ristich/TC0xC/Art/review_back.png

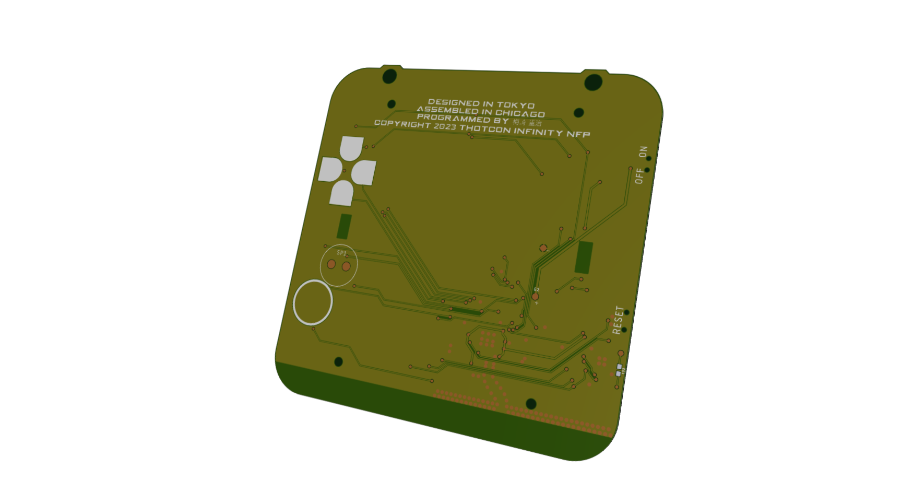
Art/review_back.png
