ristich/TC0xC/Art/review_front.png

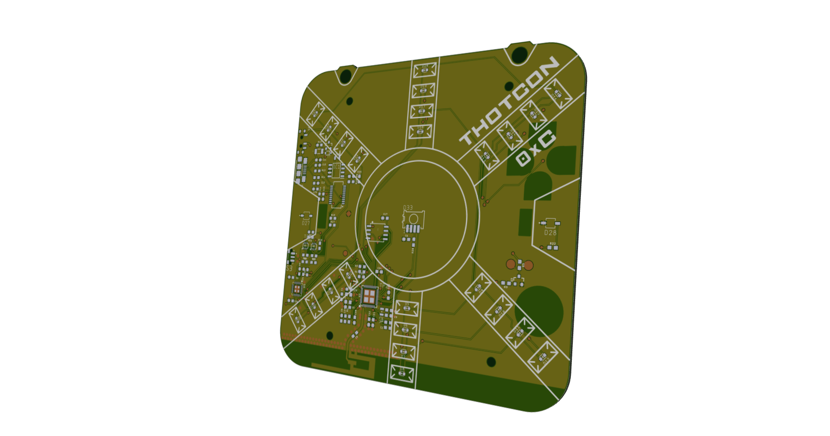
Art/review_front.png
