ristich/TC0xC/Hardware/Release/BOM_FINAL.xlsx

THOTCON 0xC Final Release
Item # | Quantity per board | Manufacturer Part # | Do Not Install | Reference designators | Vendor (optional) | Vendor Part Number (optional) | Part description/ specs (optional, but recommended) | Manfacturer (optional)
1 | 2 | 06035A271JAT2A |  | C1, C2 | Digi-Key | 478-1180-1-ND | CAP CER 270PF 50V C0G/NP0 0603 | KYOCERA AVX
2 | 2 | C0603C100J5GACTU |  | C3, C4 | Digi-Key | 399-C0603C100J5GAC7867CT-ND | CAP CER 10PF 50V C0G/NP0 0603 | KEMET
3 | 1 | GCM188R71H103KA37D |  | C5 | Digi-Key | 490-4778-1-ND | CAP CER 10000PF 50V X7R 0603 | Murata Electronics
4 | 10 | C0603C104Z3VACTU |  | C11, C14, C17, C20, C21, C23, C25, C75, C6, C35 | Digi-Key | 399-C0603C104Z3VAC7867CT-ND | CAP CER 0.1UF 25V Y5V 0603 | KEMET
5 | 1 | C0603C569J5GACTU |  | C8 | Digi-Key | 399-C0603C569J5GAC7867CT-ND | CAP CER 5.6PF 50V C0G/NP0 0603 | KEMET
6 | 2 | 06035A150JAT2A |  | C9, C26 | Digi-Key | 478-1165-1-ND | CAP CER 15PF 50V C0G/NP0 0603 | KYOCERA AVX
7 | 2 | 06035A470JAT2A |  | C12, C13 | Digi-Key | 478-1171-1-ND | CAP CER 47PF 50V C0G/NP0 0603 | KYOCERA AVX
8 | 1 | C0603C475K9PACTU |  | C15 | Digi-Key | 399-C0603C475K9PAC7867CT-ND | CAP CER 4.7UF 6.3V X5R 0603 | KEMET
9 | 1 | CL10C101JB8NNNC |  | C18 | Digi-Key | 1276-1008-1-ND | CAP CER 100PF 50V C0G/NP0 0603 | Samsung Electro-Mechanics
10 | 1 | JMK107ABJ106MA-T |  | C22 | Digi-Key | 587-5869-1-ND | CAP CER 10UF 6.3V X5R 0603 | Taiyo Yuden
11 | 2 | CL10A105KO8NNNC |  | C24, C34 | Digi-Key | 1276-1034-1-ND | CAP CER 1UF 16V X5R 0603 | Samsung Electro-Mechanics
12 | 1 | GRM1887U1H302JA01D |  | C27 | Digi-Key | 490-6396-1-ND | CAP CER 3000PF 50V U2J 0603 | Murata Electronics
13 | 1 | CC0805ZRY5V8BB105 |  | C29 | Digi-Key | 311-1358-1-ND | CAP CER 1UF 25V Y5V 0805 | YAGEO
14 | 1 | LMK107B7225KA-T |  | C30 | Digi-Key | 587-2983-1-ND | CAP CER 2.2UF 10V X7R 0603 | Taiyo Yuden
15 | 1 | C0603C224K3RACTU |  | C32 | Digi-Key | 399-C0603C224K3RAC7867CT-ND | CAP CER 0.22UF 25V X7R 0603 | KEMET
16 | 2 | VSMB2020X01 |  | D27,D28 | Digi-Key | VSMB2020X01CT-ND | EMITTER IR 940NM 100MA SMD | Vishay Semiconductor Opto Division
17 | 25 | LTST-C190KRKT |  | D1, D2, D3, D4, D5, D6, D7, D8, D9, D10, D11, D12, D13, D14, D15, D16, D17, D18, D19, D20, D21, D22, D23, D24, D26 | Digi-Key | 160-1436-1-ND | LED RED CLEAR CHIP SMD | Lite-On Inc.
18 | 1 | PTS120615V050 |  | F1 | Digi-Key | 283-3140-1-ND | PTC RESET FUSE 15V 500MA 1206 | Eaton - Electronics Division
19 | 1 | 10118192-0002LF |  | J1 | Digi-Key | 609-5379-1-ND | CONN RCPT USB2.0 MICRO B SMD R/A | Amphenol ICC (FCI)
21 | 1 | SI2307BDS-T1-E3 |  | Q1 | Digi-Key | SI2307BDS-T1-E3CT-ND | MOSFET P-CH 30V 2.5A SOT23-3 | Vishay Siliconix
22 | 2 | MBT3904DW1T1G |  | Q2,Q4 | Digi-Key | MBT3904DW1T1GOSCT-ND | TRANS 2NPN 40V 0.2A SC88/SC70-6 | onsemi
23 | 1 | PBSS4350T,215 |  | Q3 | Digi-Key | 1727-5113-1-ND | TRANS NPN 50V 2A TO236AB | Nexperia USA Inc.
24 | 12 | RMCF0603JT10K0 |  | R1, R3, R4, R7, R8, R10, R12, R17, R18, R19 | Digi-Key | RMCF0603JT10K0CT-ND | RES 10K OHM 5% 1/10W 0603 | Stackpole Electronics Inc
25 | 2 | ERJ-3EKF2002V |  | R2,R6 | Digi-Key | RMCF0603FT20K0TR-ND | RES SMD 20K OHM 1% 1/10W 0603 | Panasonic Electronic Components
26 | 2 | ERA-3AHD270V |  | R13, R14 | Digi-Key | P123789CT-ND | RES SMD 27 OHM 0.5% 1/10W 0603 | Panasonic Electronic Components
27 | 5 | RNCP0603FTD1K00 |  | R5,R9,R11,R15,R16 | Digi-Key | RNCP0603FTD1K00CT-ND | RES 1K OHM 1% 1/8W 0603 | Stackpole Electronics Inc
28 | 1 | TL3340AF160QG |  | S3 | Digi-Key | EG4627CT-ND | SWITCH TACTILE SPST-NO 0.05A 12V | E-Switch
29 | 1 | ESP32-D0WDQ6 |  | U2 | Digi-Key | 1904-1004-1-ND | IC RF TXRX+MCU BLUETOOTH 48VFQFN | Espressif Systems
30 | 1 | AP2112K-3.3TRG1 |  | IC1 | Digi-Key | AP2112M-3.3TRG1DICT-ND | IC REG LINEAR 3.3V 600MA 8SOIC | Diodes Incorporated
31 | 1 | FT231XS-R |  | U4 | Newark | 83T7089 | FT231XS-R Interface RS232, RS422, RS485, SIE, UART 3MBd, 5 V, 20-Pin, SSOP | FTDI
32 | 1 | W25Q32JVSSIQ |  | U5 | Digi-Key | WICC-1062-ND | IC FLASH 32MBIT SPI/QUAD 8SOIC - custom flash | Winbond Electronics
33 | 1 | TSOP36138TT |  | D33 | Mouser | 782-TSOP36138TT | Infrared Receivers 2.7-5.5V 38kHz 45Deg | Vishay Semiconductors
34 | 1 | IS31FL3731-QFLS2-TR |  | U1 | Digi-Key | 2521-IS31FL3731-QFLS2-TRCT-ND | IC LED DRV LIN ANALOG 34MA 28QFN | Lumissil Microsystems
36 | 1 | TSX-3225 26.0000MF09Z-AC3 |  | Y1 | Digi-Key | SER3627CT-ND | CRYSTAL 26.0000MHZ 9PF SMD | EPSON
37 | 1 | FC-135 32.7680KA-A5 |  | Y2 | Digi-Key | SER4080CT-ND | CRYSTAL 32.7680KHZ 12.5PF SMD | EPSON
38 | 1 | CUS-12TB |  | S2 | Digi-Key | 563-1102-1-ND | SWITCH SLIDE SPDT 300MA 4V | Nidec Copal Electronics
39 | 1 | 1N5711WS-7-F |  | D25 | Digi-Key | 1N5711WS-FDICT-ND | DIODE SCHOTTKY 70V 150MW SOD323 | Diodes Incorporated
40 | 1 | RNCP0603FTD100R |  | R20 | Digi-Key | RNCP0603FTD100RCT-ND | RES 100 OHM 1% 1/8W 0603 | Stackpole Electronics Inc
41 | 1 | 2479 |  | G2 | Digi-Key | 36-2479-ND | Battery Holder AAA 3 Cell PN PIN | Keystone
42 | 1 | PS1240P02BT |  | SP1 | Digi-Key | 445-2525-1-ND | AUDIO PIEZO TRANSDUCER 30V TH | TDK Corporation
43 | 2 | 755-SDR03EZPJ241 |  | R21,R22 | Mouser | 755-SDR03EZPJ241 | 240 Ohm 0603 R 5% tol | Rohm Semiconductor
44 | 2 | RT0603FRE13100KL |  | R24,R25 | Mouser | 603-RT0603FRE13100KL | 100K Ohm 0603 R 5% tol | Yageo
45 | 2 | CRG0603F22R |  | R23,R26 | Mouser | 279-CRG0603F22R | 22 Ohm 0604 R 5% tol | TE Connectivity
46 | 2 | RUC002N05 HZG |  | Q5,Q6 | Digi-Key | RUC002N05HZGT116CT-ND | Nch 50V 200mA Small Signal MOSFET | Rohm Semiconductor
END OF BOM
