ristich/TC0xC/Hardware/Prototype/thot_C_proto_bom.xlsx

Item # | Qty | Ref. Des | Manufacturer | Mfg. Part # | Dist. Part # | Description | Value | Device | Package | PROD_ID
1 | 2 | C1, C2 | AVX | 06035A271JAT2A | 478-1180-1-ND | CAP-13339 | 270pF | 270PF-50V-5%(0603) | 603 | CAP-13339
2 | 2 | C3, C4 | Kemet | C0603C100J5GACTU | 399-1049-1-ND | 10pF ceramic capacitors | 10pF | 10PF-0603-50V-5% | 603 | CAP-11812
3 | 1 | C5 | Murata | GCM188R71H103KA37D | 490-4778-1-ND | 0.01uF/10nF/10,000pF ceramic capacitors | 10nF | 10NF-0603-50V-10% | 603 | CAP-00867
4 | 11 | C7, C11, C14, C16, C17, C20, C21, C23, C25, C33, C35 | Kemet | C0603C104Z3VACTU | 399-1100-1-ND | 0.1µF ceramic capacitors | 0.1uF | 0.1UF-0603-25V-(+80/-20%) | 603 | CAP-00810
5 | 1 | C8 | Kemet | C0603C569J5GACTU | 399-9111-1-ND | CAP-12456 | 5.6pF | 5.6PF-50V-5%(0603) | 603 | CAP-12456
6 | 2 | C9, C26 | AVX | 06035A150JAT2A | 478-1165-1-ND | 15pF ceramic capacitors | 15pF | 15PF-0603-50V-5% | 603 | CAP-07881
7 | 2 | C12, C13 | AVX | 06035A470JAT2A | 478-1171-1-ND | 47pF ceramic capacitors | 47pF | 47PF-0603-50V-5% | 603 | CAP-08913
8 | 1 | C15 | Kemet | C0603C475K9PACTU | 399-3482-1-ND | CAP-08280 | 4.7uF | 4.7UF-6.3V-10%(0603)0603 | 0603-CAP | CAP-08280
9 | 1 | C18 | Samsung | CL10C101JB8NNNC | 490-1427-1-ND | 100pF/0.1nF ceramic capacitors | 100pF | 100PF-0603-50V-5% | 603 | CAP-07883
10 | 2 | C22, C31 | Taiyo Yuden | JMK107ABJ106MA-T | 587-5869-1-ND | 10.0 µF ceramic capacitors | 10uF | 10UF-0603-6.3V-20% | 603 | CAP-11015
11 | 2 | C24, C34 | Samsung | CL10A105KO8NNNC | 1276-1034-1-ND | 1µF ceramic capacitors | 1.0uF | 1.0UF-0603-16V-10% | 603 | CAP-00868
12 | 1 | C27 | Murata | GRM1887U1H302JA01D | 490-6396-1-ND | 3.0nF (3nF, 3000pF) ceramic capacitors | 3.0nF | 3.0NF-0603-50V-5% | 603 | CAP-13515
13 | 1 | C29 | Yageo | CC0805ZRY5V8BB105 | 311-1358-1-ND | 1µF ceramic capacitors | 1.0uF | 1.0UF-0805-25V-(+80/-20%) | 805 | CAP-11625
14 | 1 | C30 | Taiyo Yuden | LMK107B7225KA-T | 587-2983-1-ND | 2.2 µF ceramic capacitors | 2.2uF | 2.2UF-0603-10V-20% | 603 | CAP-07888
15 | 1 | C32 | Kemet | C0603C224K3RACTU | 399-7884-1-ND | 0.22µF Ceramic Capacitor | 0.22uF | 0.22UF-0603-25V-10% | 603
16 | 2 | D1,D4 | Vishay | VSMB2020X01 | 782-VSMB2020X01 | Infrared Emitters - High Power 940nm, SMD 40mW/sr, +/-12deg. | 950nM | INFRARED-EMITTING DIODE | 2-SMD, Gull Wing
17 | 1 | D2 | ON Semiconductor | MMDL770T1G | MMDL770T1GOSCT-ND | Schottky diodes in SFE's production catalog | BAT20J | DIODE-SCHOTTKY-BAT20J | SOD-323 | DIO-11623
18 | 1 | D3 | Lite-ON | LTST-C191KFKT | 160-1445-1-ND | Orange SMD LED | ORANGE | LED-RED0603 | LED-0603 | DIO-00819
19 | 24 | D1-24 | Lite-ON | LTST-C190KRKT | 160-1436-1-ND | LED RED CLEAR 2PLCC SMD | RED | LED-RED0603 | LED-0604
20 | 1 | F1 | Cooper Bussmann | PTS120615V050 | 283-3140-1-ND | Resettable Fuse PTC | 500mA | PTCSMD | PTC-1206 | RES-11150
21 | 1 | J1 | Amphenol ICC (FCI) | 10118192-000 2 LF | 609-5379-1-ND | USB Micro-B connectors |  | USB_MICROB_PLUGCONN-11752 | USB-B-MICRO-SMD_V03 | CONN-11752
22 | 1 | LS1 | TDK Corporation | PS1240P02BT | 445-2525-1-ND | AUDIO PIEZO TRANSDUCER 30V TH |  |  | Through Hole
23 | 1 | Q1 | Vishay | SI2307BDS-T1-E3 | SI2307BDS-T1-E3CT-ND | Generic PMOSFET | 2.5A/30V | MOSFET-PCHANNELDMG2307L | SOT23-3 | TRANS-11308
24 | 1 | Q2 | ON Semiconductor | MBT3904DW1T1G | MBT3904DW1T1GOSCT-ND | MBT3904DW1 Dual NPN Transistors | MBT3904DW1T1 | MBT3904DW1T1 | SC70-6 | TRANS-13337
25 | 1 | Q3 | Nexperia | PBSS4350T,215 | 1727-5113-1-ND | TRANS NPN 50V 2A SOT23 |  |  | SOT-23-3
26 | 10 | R1, R3, R4, R8, R9, R12, R17, R18, R19, R20 | Stackpole | RMCF0603JT10K0 | RMCF0603JT10K0CT-ND | 10k resistor | 10k | 10KOHM-0603-1/10W-1% | 603 | RES-00824
27 | 1 | R2 | Panasonic | ERJ-3EKF2002V | P20.0KHCT-ND | 20k resistor | 20k | 20KOHM-0603-1/10W-1% | 603 | RES-09383
28 | 2 | R13, R14 | Panasonic | ERA-3AHD270V | P123789CT-ND | RES-09334 | 27 | 27OHM1/10W1%(0603)0603-RES | 603 | RES-09334
29 | 1 | R15 | Panasonic | ERA-3AED102V | P123733CT-ND | RES-07856 | 1K | 1KOHM-1/10W-1%(0603) | 603 | RES-07856
30 | 1 | S1 | C&K Components | KMR223GLFG | 401-1428-1-ND | Various NO switches- pushbuttons, reed, etc | RESET | SWITCH-MOMENTARY-2SMD-4.6X2.8MM | TACTILE_SWITCH_SMD_4.6X2.8MM | SWCH-13065
31 | 1 | U2 | Espressif | ESP32-D0WDQ6 | 1904-1004-1-ND | ESP32 IC | ESP3212 | ESP3212 | QFN48-0.4MM | IC-13338
32 | 1 | U3 | Diodes Incorporated | AP2112K-3.3TRG1 | AP2112K-3.3TRG1DICT-ND | Voltage Regulator LDO | AP2112K-3.3V | V_REG_LDOSMD | SOT23-5 | VREG-12457
33 | 1 | U4 | FTDI | FT231XS-R | 83T7089 | FTDI FT231X Full Speed USB to Full-handshake UART | FT231XS | FT231XS | SSOP20_L | IC-11524
34 | 1 | U5 | Winbond | W25Q32JVSSIQ | W25Q32JVSSIQ-ND | Winbond W25Q32FV 32Mbit (4MB) Flash | W25Q32FVSS | W25Q32FVSS | SOIC-8 | IC-13229
35 | 1 | D33 | Vishay | TSOP36138TT | 782-TSOP36138TT | Infrared Receivers 2.7-5.5V 38kHz 45Deg | 38 kHz | TSOP36138 | LGA-16
36 | 1 | U7 | ISSI | IS31FL3731-QFLS2-TR | 870-31FL3731-QFLS2TR | LED Driver IC 16 Output Linear I²C Dimming 24-QFN (4x4) |  |  | QFN-24
37 | 1 | U$15 | Keystone | 2479 | 36-2479-ND | Battery Holder AAA 3 Cell PN PIN | n/a | 2479 | THRU-PCB
38 | 1 | Y1 | Epson | TSX-3225 26.0000MF09Z-AC3 | SER3627CT-ND | 26MHz Crystal | 26MHz | CRYSTAL-GROUNDED3.2X2.5 | CRYSTAL-SMD-3.2X2.5 | XTAL-12454
39 | 1 | Y2 | Epson | FC-135 32.7680KA-A5 | SER4103CT-ND | 32.768kHz Crystal | 32.768kHz | CRYSTAL-32.768KHZSMD-3.2X1.5 | CRYSTAL-SMD-3.2X1.5MM | XTAL-13062
40 | 2 |  |  | RC0603FR-078R2L | 13-RC0603FR-078R2LTR-ND | 8.2 Resitor | 8.2
41 | 1 | S
