ristich/TC0xC/Hardware/Housing/TC0xC_cover_inner.step

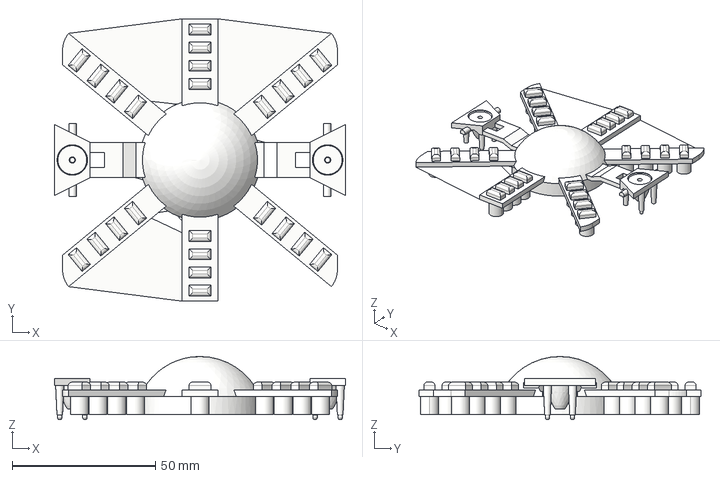
[picture p3: CAD file, 2023-03-19]
Hardware/Housing/TC0xC_cover_inner.step
101.6 x 98.6 x 22.0 mm
