ristich/TC0xC/Hardware/Housing/TC0xC_cover_outer.step

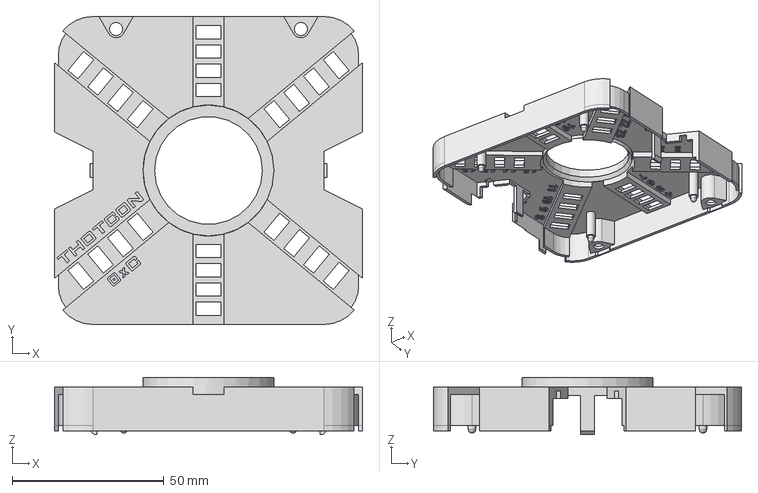
[picture p4: CAD file, 2023-03-19]
Hardware/Housing/TC0xC_cover_outer.step
101.6 x 101.6 x 18.9 mm
