ristich/TC0xC/(list of files, cad)

Other CAD files:
Hardware/Housing/TC0xC_cover_inner.stl
Hardware/Housing/TC0xC_cover_outer.stl
