ristich/TC0xC/Hardware/Release/tc0xC_prod.brd

## EAGLE design Hardware/Release/tc0xC_prod.brd (2023-04-10)

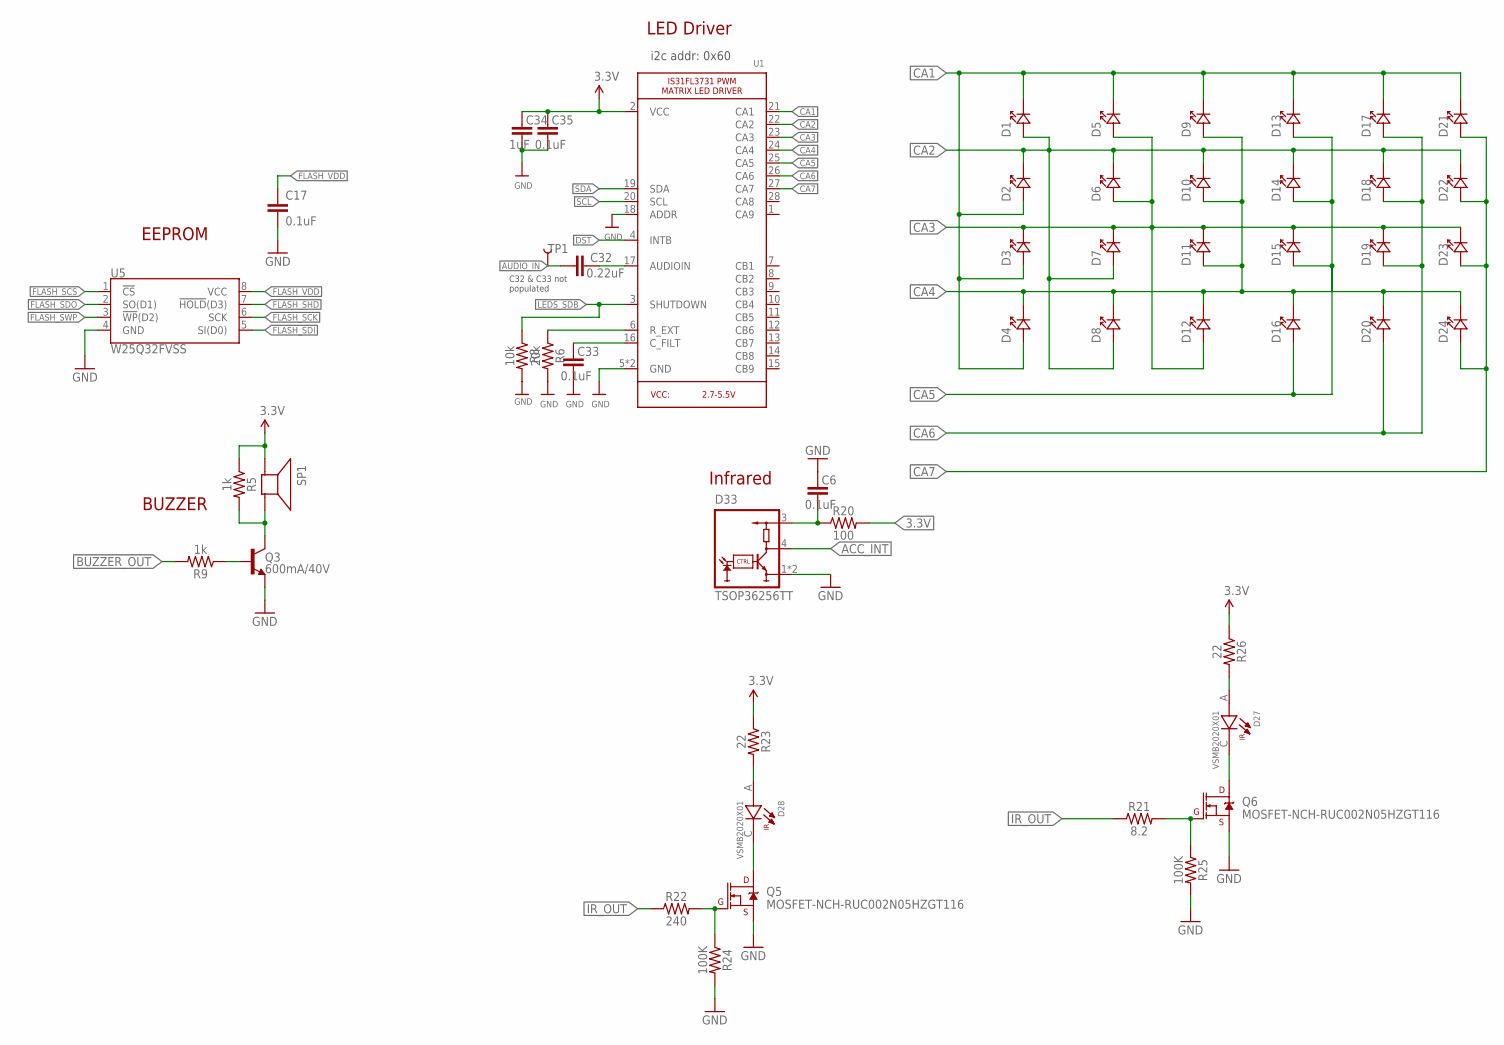
[picture p5: schematic tc0xC_prod.sch, sheet 1]

Parts:
C6, C17, C33, C35: 0.1uF; 0603
C32: 0.22uF; 0603
C34: 1uF; 0603
D1, D2, D3, D4, D5, D6, D7, D8, D9, D10, D11, D12, D13, D14, D15, D16, D17, D18, D19, D20, D21, D22, D23, D24: LED-603; SMD-603
D27, D28: VSMB2020X01; DIO_VSMB2020X01
D33: TSOP36256TT; TSOP36256
Q3: 600mA/40V; SOT23-3
Q5, Q6: MOSFET-NCH-RUC002N05HZGT116; SOT-23-3
R5, R9: 1k; 0603
R6: 20k; 0603
R8: 10k; 0603
R20: 100; 0603
R21: 8.2; 0603
R22: 240; 0603
R23, R26: 22; 0603
R24, R25: 100K; 0603
SP1: SPEAKER/PS12; PS12
TP1: TEST-POINT3X5; PAD.03X.05
U1: IS31FL3731QFN; QFN-28_4MM_0.4MM
U5: W25Q32FVSS; SOIC-8

Connections:
3.3V: C34.1, C35.1, R5.1, R20.2, R23.1, R26.1, SP1.P$1 (+), U1.2 (VCC); also elsewhere on the board
ACC_INT: D33.4 (OUT); also elsewhere on the board
AUDIO_IN: C32.1, TP1.P$1
BUZZER_OUT: R9.2; also elsewhere on the board
CA1: D1.P$2 (CATHODE-), D2.P$1 (ANODE+), D3.P$1 (ANODE+), D4.P$1 (ANODE+), D5.P$2 (CATHODE-), D9.P$2 (CATHODE-), D13.P$2 (CATHODE-), D17.P$2 (CATHODE-), D21.P$2 (CATHODE-), U1.21 (CA1)
CA2: D1.P$1 (ANODE+), D2.P$2 (CATHODE-), D6.P$2 (CATHODE-), D7.P$1 (ANODE+), D8.P$1 (ANODE+), D10.P$2 (CATHODE-), D14.P$2 (CATHODE-), D18.P$2 (CATHODE-), D22.P$2 (CATHODE-), U1.22 (CA2)
CA3: D3.P$2 (CATHODE-), D5.P$1 (ANODE+), D6.P$1 (ANODE+), D7.P$2 (CATHODE-), D11.P$2 (CATHODE-), D12.P$1 (ANODE+), D15.P$2 (CATHODE-), D19.P$2 (CATHODE-), D23.P$2 (CATHODE-), U1.23 (CA3)
CA4: D4.P$2 (CATHODE-), D8.P$2 (CATHODE-), D9.P$1 (ANODE+), D10.P$1 (ANODE+), D11.P$1 (ANODE+), D12.P$2 (CATHODE-), D16.P$2 (CATHODE-), D20.P$2 (CATHODE-), D24.P$2 (CATHODE-), U1.24 (CA4)
CA5: D13.P$1 (ANODE+), D14.P$1 (ANODE+), D15.P$1 (ANODE+), D16.P$1 (ANODE+), U1.25 (CA5)
CA6: D17.P$1 (ANODE+), D18.P$1 (ANODE+), D19.P$1 (ANODE+), D20.P$1 (ANODE+), U1.26 (CA6)
CA7: D21.P$1 (ANODE+), D22.P$1 (ANODE+), D23.P$1 (ANODE+), D24.P$1 (ANODE+), U1.27 (CA7)
DST: U1.4 (INTB); also elsewhere on the board
FLASH_SCK: U5.6 (SCK); also elsewhere on the board
FLASH_SCS: U5.1 (!CS!); also elsewhere on the board
FLASH_SDI: U5.5 (SI(D0)); also elsewhere on the board
FLASH_SDO: U5.2 (SO(D1)); also elsewhere on the board
FLASH_SHD: U5.7 (!HOLD!(D3)); also elsewhere on the board
FLASH_SWP: U5.3 (!WP!(D2)); also elsewhere on the board
FLASH_VDD: C17.1, U5.8 (VCC); also elsewhere on the board
GND: C6.1, C17.2, C33.2, C34.2, C35.2, D33.1 (GND), D33.2 (GND), Q3.2 (E), Q5.2 (S), Q6.2 (S), R6.2, R8.2, R24.2, R25.2, U1.5 (GND), U1.18 (ADDR), U1.THERMAL (GND), U5.4 (GND); also elsewhere on the board
IR_OUT: R21.1, R22.1; also elsewhere on the board
LEDS_SDB: R8.1, U1.3 (SHUTDOWN); also elsewhere on the board
unnamed: C33.1, U1.16 (C_FILT)
unnamed: R6.1, U1.6 (R_EXT)
unnamed: Q3.3 (C), R5.2, SP1.P$2 (-)
unnamed: Q6.1 (G), R21.2, R25.1
unnamed: Q5.1 (G), R22.2, R24.1
unnamed: C32.2, U1.17 (AUDIOIN)
unnamed: C6.2, D33.3 (VS), R20.1
unnamed: D28.C, Q5.3 (D)
unnamed: D28.A, R23.2
unnamed: D27.C, Q6.3 (D)
unnamed: D27.A, R26.2
unnamed: Q3.1 (B), R9.1
SCL: U1.20 (SCL); also elsewhere on the board
SDA: U1.19 (SDA); also elsewhere on the board

Notes on the sheet:
i2c addr: 0x60
C32 & C33 not populated
EEPROM
BUZZER
LED Driver
Infrared

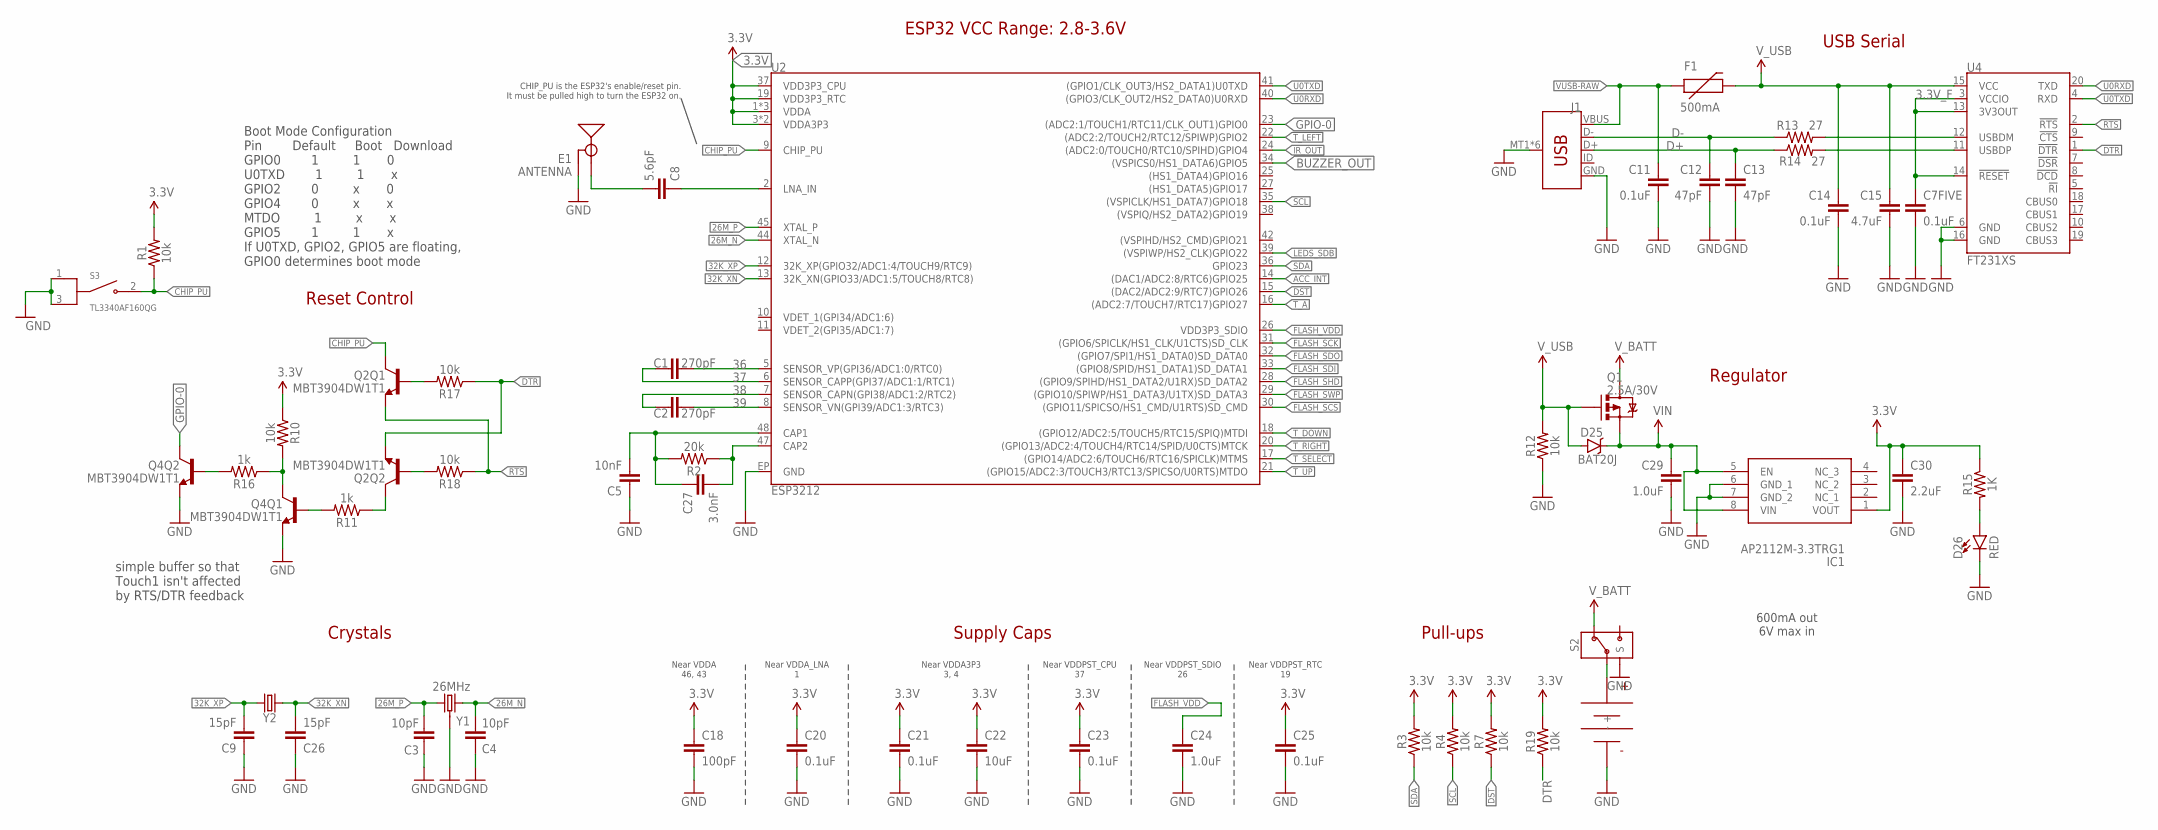
[picture p6: schematic tc0xC_prod.sch, sheet 2]

Parts:
C1, C2: 270pF; 0603
C3, C4: 10pF; 0603
C5: 10nF; 0603
C7FIVE, C11, C14, C20, C21, C23, C25: 0.1uF; 0603
C8: 5.6pF; 0603
C9, C26: 15pF; 0603
C12, C13: 47pF; 0603
C15: 4.7uF; 0603
C18: 100pF; 0603
C22: 10uF; 0603
C24: 1.0uF; 0603
C27: 3.0nF; 0603
C29: 1.0uF; 0805
C30: 2.2uF; 0603
D25: BAT20J; SOD-323
D26: RED; LED-0603@1
E1: ANTENNA; TRACE_ANTENNA_2.4GHZ_25.7MM_TUNED
F1: 500mA; PTC-1206
G2: KEYSTONE_2479
IC1: AP2112M-3.3TRG1; SOIC127P600X170-8N
J1: USB_MICRO-B; USB-MICROB-10118192
Q1: 2.5A/30V; SOT23-3@1
Q2, Q4: MBT3904DW1T1; SC70-6
R1, R3, R4, R7, R10, R12, R17, R18, R19: 10k; 0603
R2: 20k; 0603
R11, R16: 1k; 0603
R13, R14: 27; 0603
R15: 1K; 0603
S2: CUS-12B; CUS-12_SPDT
S3: TL3340AF160QG; SW_TL3340AF160QG
U2: ESP3212; QFN48-0.4MM
U4: FT231XS; SSOP20_L
Y1: 26MHz; CRYSTAL-SMD-3.2X2.5
Y2: 32.768kHz; FC-12M

Connections:
3.3V: C18.1, C20.1, C21.1, C22.1, C23.1, C25.1, C30.1, IC1.1 (VOUT), R1.2, R3.2, R4.2, R7.2, R10.1, R15.1, R19.2, U2.1 (VDDA), U2.3 (VDDA3P3), U2.4 (VDDA3P3), U2.19 (VDD3P3_RTC), U2.37 (VDD3P3_CPU), U2.43 (VDDA), U2.46 (VDDA); also elsewhere on the board
3.3V_F: C7FIVE.1, U4.3 (VCCIO), U4.13 (3V3OUT), U4.14 (!RESET)
26M_N: C4.2, U2.44 (XTAL_N), Y1.3 (2)
26M_P: C3.2, U2.45 (XTAL_P), Y1.1
32K_XN: C26.2, U2.13 (32K_XN(GPIO33/ADC1:5/TOUCH8/RTC8)), Y2.2
32K_XP: C9.2, U2.12 (32K_XP(GPIO32/ADC1:4/TOUCH9/RTC9)), Y2.1
36: C1.2, U2.5 (SENSOR_VP(GPI36/ADC1:0/RTC0))
37: C1.1, U2.6 (SENSOR_CAPP(GPI37/ADC1:1/RTC1))
38: C2.1, U2.7 (SENSOR_CAPN(GPI38/ADC1:2/RTC2))
39: C2.2, U2.8 (SENSOR_VN(GPI39/ADC1:3/RTC3))
ACC_INT: U2.14 ((DAC1/ADC2:8/RTC6)GPIO25); also elsewhere on the board
BUZZER_OUT: U2.34 ((VSPICS0/HS1_DATA6)GPIO5); also elsewhere on the board
CAP_10N: C5.2, C27.1, R2.2, U2.48 (CAP1)
CHIP_PU: Q2.3 (C), R1.1, S3.2 (NO), U2.9 (CHIP_PU)
D+: C13.1, J1.D+, R14.1
D-: C12.1, J1.D-, R13.1
DST: R7.1, U2.15 ((DAC2/ADC2:9/RTC7)GPIO26); also elsewhere on the board
DTR: Q2.1 (E), R17.1, R19.1, U4.1 (!DTR)
FLASH_SCK: U2.31 ((GPIO6/SPICLK/HS1_CLK/U1CTS)SD_CLK); also elsewhere on the board
FLASH_SCS: U2.30 ((GPIO11/SPICSO/HS1_CMD/U1RTS)SD_CMD); also elsewhere on the board
FLASH_SDI: U2.33 ((GPIO8/SPID/HS1_DATA1)SD_DATA1); also elsewhere on the board
FLASH_SDO: U2.32 ((GPIO7/SPI1/HS1_DATA0)SD_DATA0); also elsewhere on the board
FLASH_SHD: U2.28 ((GPIO9/SPIHD/HS1_DATA2/U1RX)SD_DATA2); also elsewhere on the board
FLASH_SWP: U2.29 ((GPIO10/SPIWP/HS1_DATA3/U1TX)SD_DATA3); also elsewhere on the board
FLASH_VDD: C24.1, U2.26 (VDD3P3_SDIO); also elsewhere on the board
GND: C3.1, C4.1, C5.1, C7FIVE.2, C9.1, C11.2, C12.2, C13.2, C14.2, C15.2, C18.2, C20.2, C21.2, C22.2, C23.2, C24.2, C25.2, C26.1, C29.2, C30.2, D26.C, E1.GND, E1.GND2 (GND), G2.-, IC1.6 (GND_1), IC1.7 (GND_2), J1.GND, J1.MT1 (SHIELD), J1.MT2 (SHIELD), J1.MT3 (SHIELD), J1.MT4 (SHIELD), J1.P$1 (SHIELD), J1.P$2 (SHIELD), Q4.1 (E), Q4.4 (E), R12.1, S2.P$4 (S), S2.P$5 (S), S2.P$6 (S), S2.P$7 (S), S3.1 (COM_1), S3.3 (COM_2), U2.EP (GND), U4.6 (GND), U4.16 (GND), Y1.2 (GND), Y1.4 (GND); also elsewhere on the board
GPIO-0: Q4.6 (C), U2.23 ((ADC2:1/TOUCH1/RTC11/CLK_OUT1)GPIO0)
IR_OUT: U2.24 ((ADC2:0/TOUCH0/RTC10/SPIHD)GPIO4); also elsewhere on the board
LEDS_SDB: U2.39 ((VSPIWP/HS2_CLK)GPIO22); also elsewhere on the board
LNA_IN: C8.1, U2.2 (LNA_IN)
unnamed: C27.2, R2.1, U2.47 (CAP2)
unnamed: R13.2, U4.12 (USBDM)
unnamed: R14.2, U4.11 (USBDP)
unnamed: Q4.2 (B), R16.2
unnamed: Q2.5 (B), R17.2
unnamed: Q2.2 (B), R18.2
unnamed: Q4.3 (C), R10.2, R16.1
unnamed: Q4.5 (B), R11.2
unnamed: Q2.6 (C), R11.1
unnamed: G2.+, S2.P$2 (1)
unnamed: D26.A, R15.2
RTS: Q2.4 (E), R18.1, U4.2 (!RTS)
SCL: R4.1, U2.35 ((VSPICLK/HS1_DATA7)GPIO18); also elsewhere on the board
SDA: R3.1, U2.36 (GPIO23); also elsewhere on the board
TRACE_ANT: C8.2, E1.ANT (SIGNAL)
T_A: U2.16 ((ADC2:7/TOUCH7/RTC17)GPIO27)
T_DOWN: U2.18 ((GPIO12/ADC2:5/TOUCH5/RTC15/SPIQ)MTDI)
T_LEFT: U2.22 ((ADC2:2/TOUCH2/RTC12/SPIWP)GPIO2)
T_RIGHT: U2.20 ((GPIO13/ADC2:4/TOUCH4/RTC14/SPID/U0CTS)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)
T_SELECT: U2.17 ((GPIO14/ADC2:6/TOUCH6/RTC16/SPICLK)MTMS)
T_UP: U2.21 ((GPIO15/ADC2:3/TOUCH3/RTC13/SPICSO/U0RT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)
U0RXD: U2.40 ((GPIO3/CLK_OUT2/HS2_DATA0)U0RXD), U4.20 (TXD)
U0TXD: U2.41 ((GPIO1/CLK_OUT3/HS2_DATA1)U0TXD), U4.4 (RXD)
VIN: C29.1, D25.C, IC1.5 (EN), IC1.8 (VIN), Q1.2 (S)
VUSB-RAW: C11.1, F1.1, J1.VBUS
V_BATT: Q1.3 (D), S2.P$1 (2)
V_USB: C14.1, C15.1, D25.A, F1.2, Q1.1 (G), R12.2, U4.15 (VCC)

Notes on the sheet:
Near VDDA 46, 43
Near VDDA_LNA 1
Near VDDA3P3 3, 4
Near VDDPST_CPU 37
Near VDDPST_SDIO 26
Near VDDPST_RTC 19
ESP32 VCC Range: 2.8-3.6V
CHIP_PU is the ESP32's enable/reset pin. It must be pulled high to turn the ESP32 on.
Supply Caps
Reset Control
Crystals
600mA out 6V max in
Regulator
USB Serial
Boot Mode Configuration Pin Default Boot Download GPIO0 1 1 0 U0TXD 1 1 x GPIO2 0 x 0 GPIO4 0 x x MTDO 1 x x GPIO5 1 1 x If U0TXD, GPIO2, GPIO5 are floating, GPIO0 determines boot mode
Pull-ups
simple buffer so that Touch1 isn't affected by RTS/DTR feedback

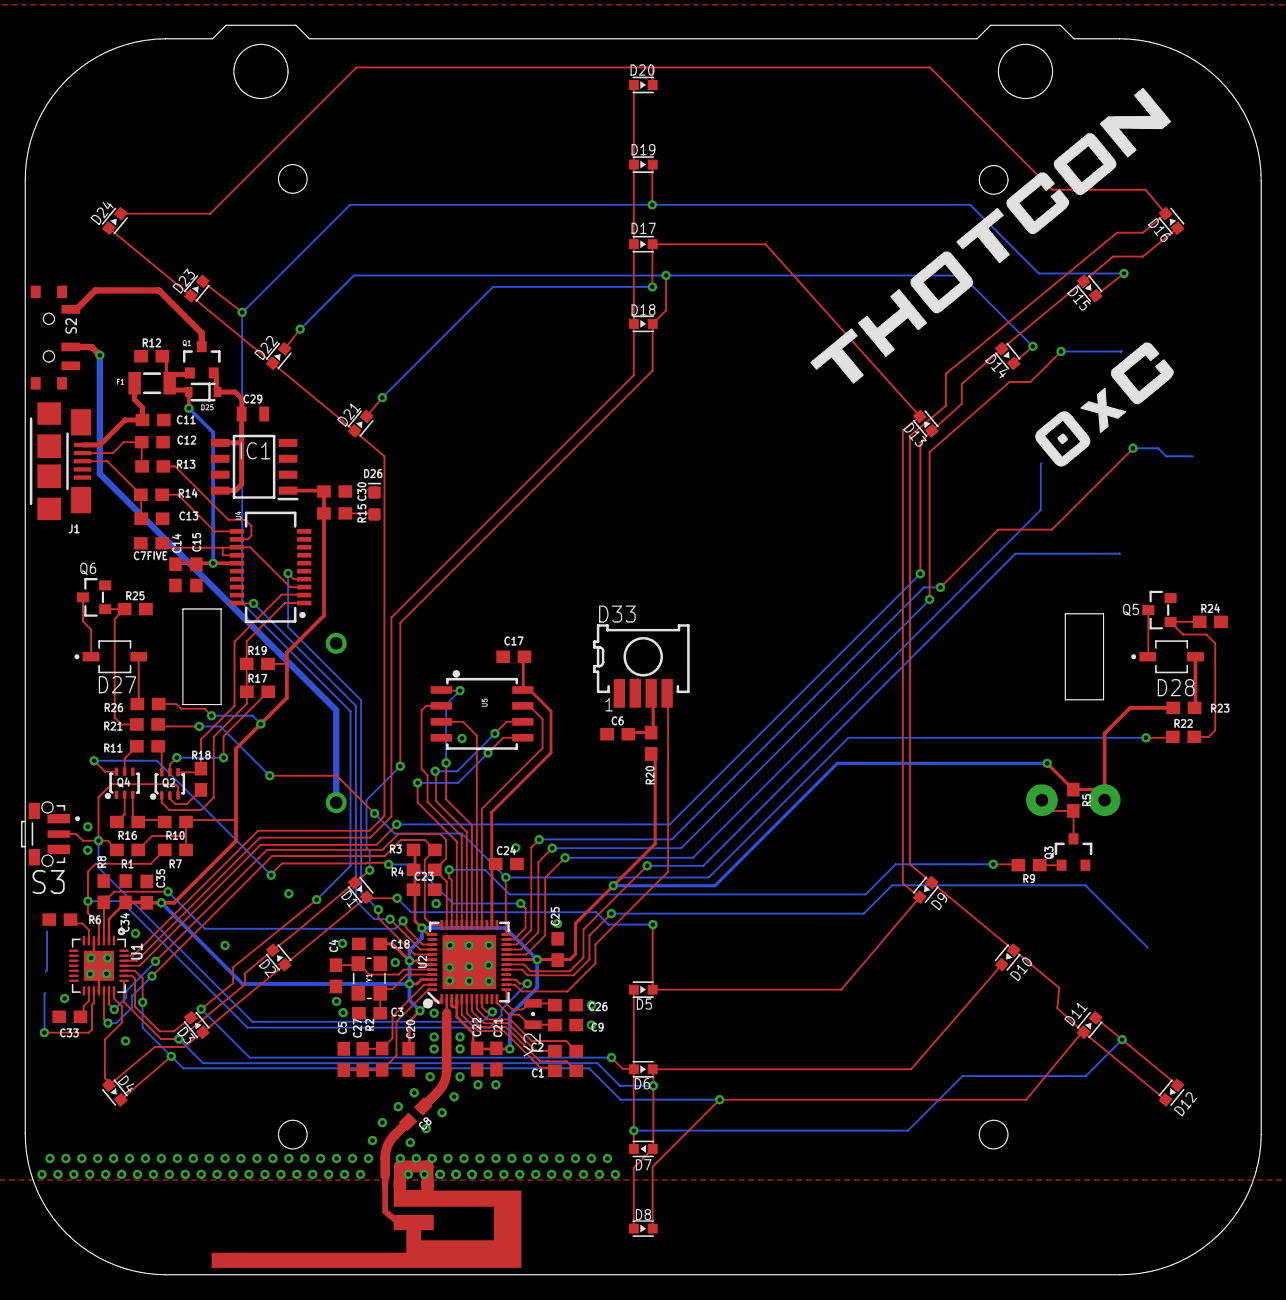
[picture p7: board tc0xC_prod.brd from above]

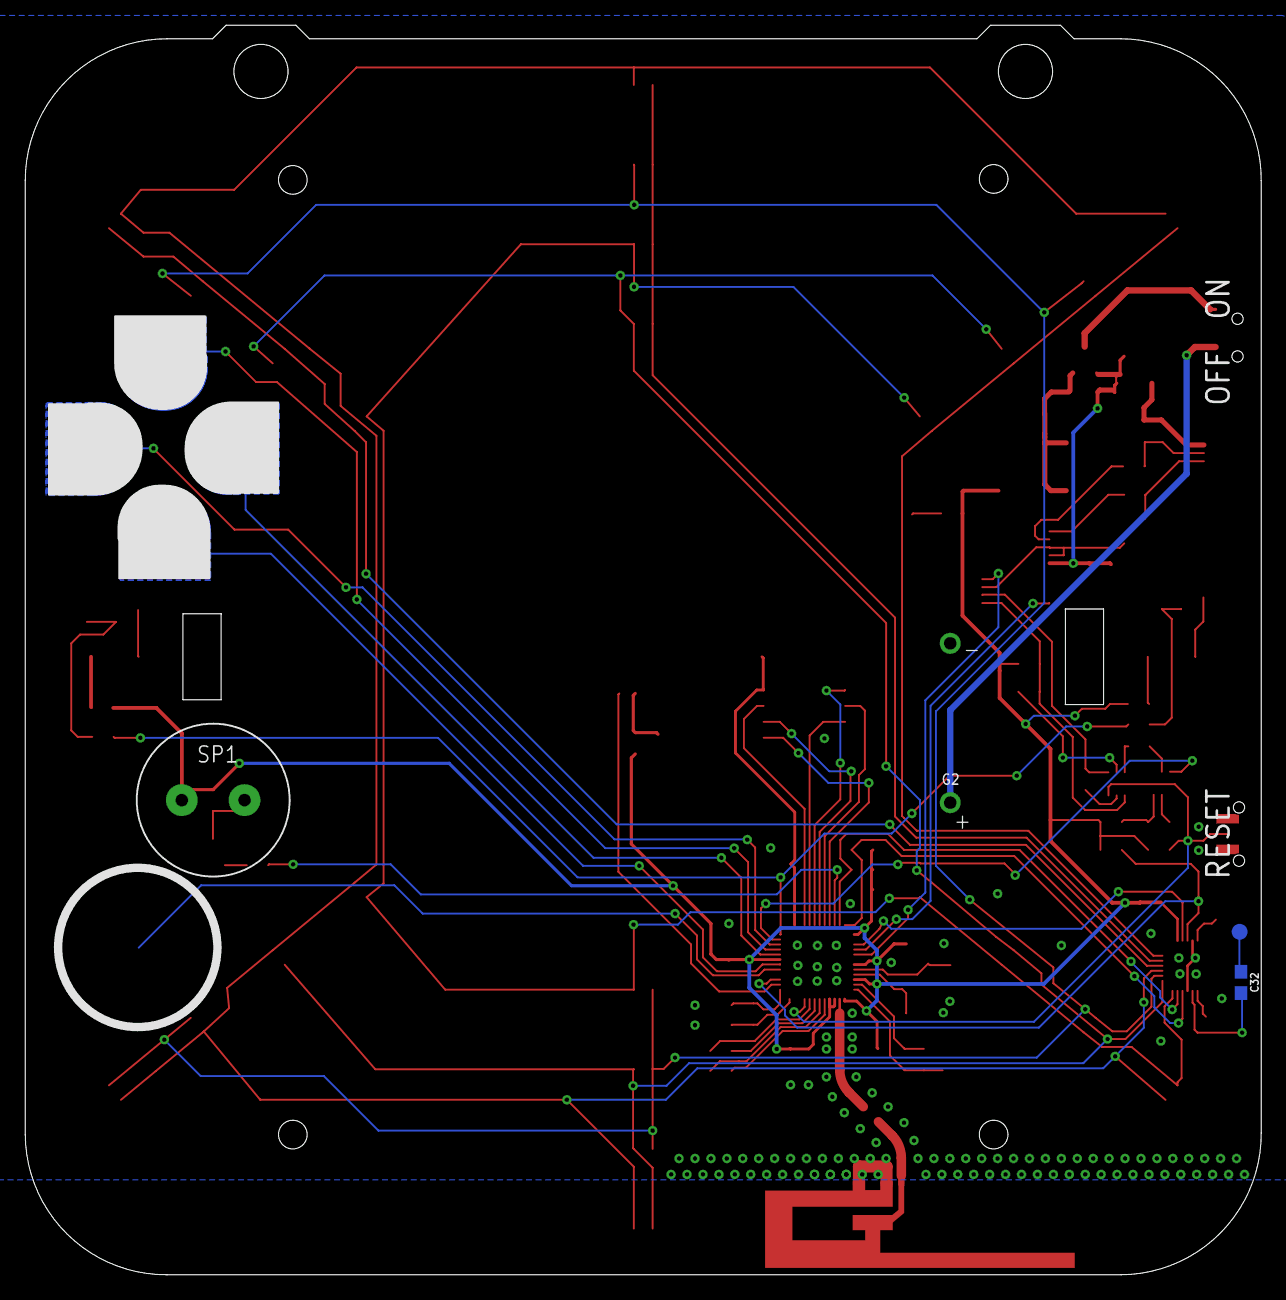
[picture p8: board tc0xC_prod.brd from below]

Board: 2 copper layers, 98.6 x 99.6 mm, 106 parts (4 on the bottom side), 71 nets.
