ristich/TC0xC/Hardware/PCB/quick_mock.brd

## EAGLE design Hardware/PCB/quick_mock.brd (2023-04-05)

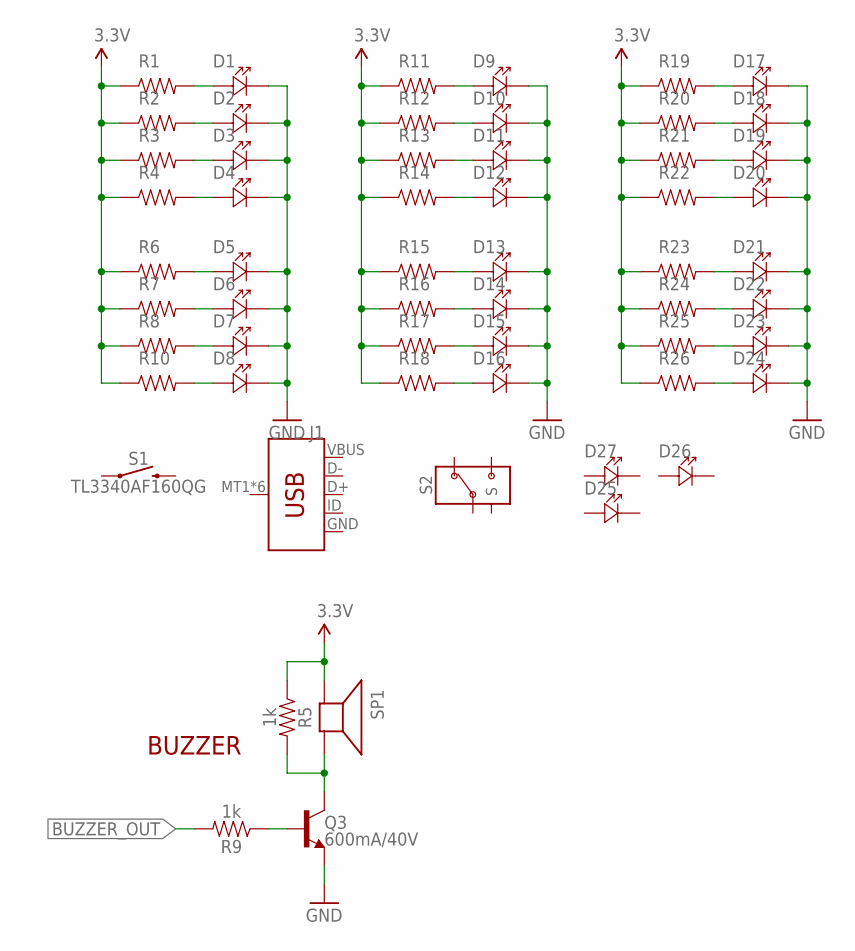
[picture p9: schematic quick_mock.sch]

Parts:
D1, D2, D3, D4, D5, D6, D7, D8, D9, D10, D11, D12, D13, D14, D15, D16, D17, D18, D19, D20, D21, D22, D23, D24, D26: LED-603; SMD-603
D25, D27: VSMB2020X01; GULL-WING-2.3MM
J1: USB_MICRO-B; USB-MICROB-10118192
Q3: 600mA/40V; SOT23-3
R1, R2, R3, R4, R6, R7, R8, R10, R11, R12, R13, R14, R15, R16, R17, R18, R19, R20, R21, R22, R23, R24, R25, R26: RESISTOR-603; SMD-603
R5, R9: 1k; 0603
S1: TL3340AF160QG; 3PIN_GULLWING_4.0X3.3MM
S2: CUS-12B; CUS-12_SPDT
SP1: SPEAKER/PS12; PS12

Connections:
3.3V: R1.1, R2.1, R3.1, R4.1, R5.1, R6.1, R7.1, R8.1, R10.1, R11.1, R12.1, R13.1, R14.1, R15.1, R16.1, R17.1, R18.1, R19.1, R20.1, R21.1, R22.1, R23.1, R24.1, R25.1, R26.1, SP1.P$1 (+)
BUZZER_OUT: R9.2
GND: D1.P$2 (CATHODE-), D2.P$2 (CATHODE-), D3.P$2 (CATHODE-), D4.P$2 (CATHODE-), D5.P$2 (CATHODE-), D6.P$2 (CATHODE-), D7.P$2 (CATHODE-), D8.P$2 (CATHODE-), D9.P$2 (CATHODE-), D10.P$2 (CATHODE-), D11.P$2 (CATHODE-), D12.P$2 (CATHODE-), D13.P$2 (CATHODE-), D14.P$2 (CATHODE-), D15.P$2 (CATHODE-), D16.P$2 (CATHODE-), D17.P$2 (CATHODE-), D18.P$2 (CATHODE-), D19.P$2 (CATHODE-), D20.P$2 (CATHODE-), D21.P$2 (CATHODE-), D22.P$2 (CATHODE-), D23.P$2 (CATHODE-), D24.P$2 (CATHODE-), J1.GND, Q3.2 (E)
unnamed: D1.P$1 (ANODE+), R1.2
unnamed: D2.P$1 (ANODE+), R2.2
unnamed: Q3.3 (C), R5.2, SP1.P$2 (-)
unnamed: D3.P$1 (ANODE+), R3.2
unnamed: D4.P$1 (ANODE+), R4.2
unnamed: D5.P$1 (ANODE+), R6.2
unnamed: D6.P$1 (ANODE+), R7.2
unnamed: D7.P$1 (ANODE+), R8.2
unnamed: D8.P$1 (ANODE+), R10.2
unnamed: D9.P$1 (ANODE+), R11.2
unnamed: D10.P$1 (ANODE+), R12.2
unnamed: D11.P$1 (ANODE+), R13.2
unnamed: D12.P$1 (ANODE+), R14.2
unnamed: D13.P$1 (ANODE+), R15.2
unnamed: D14.P$1 (ANODE+), R16.2
unnamed: D15.P$1 (ANODE+), R17.2
unnamed: D16.P$1 (ANODE+), R18.2
unnamed: D24.P$1 (ANODE+), R26.2
unnamed: D23.P$1 (ANODE+), R25.2
unnamed: D22.P$1 (ANODE+), R24.2
unnamed: D21.P$1 (ANODE+), R23.2
unnamed: Q3.1 (B), R9.1
unnamed: D20.P$1 (ANODE+), R22.2
unnamed: D19.P$1 (ANODE+), R21.2
unnamed: D18.P$1 (ANODE+), R20.2
unnamed: D17.P$1 (ANODE+), R19.2
VBUS: J1.VBUS

Notes on the sheet:
BUZZER

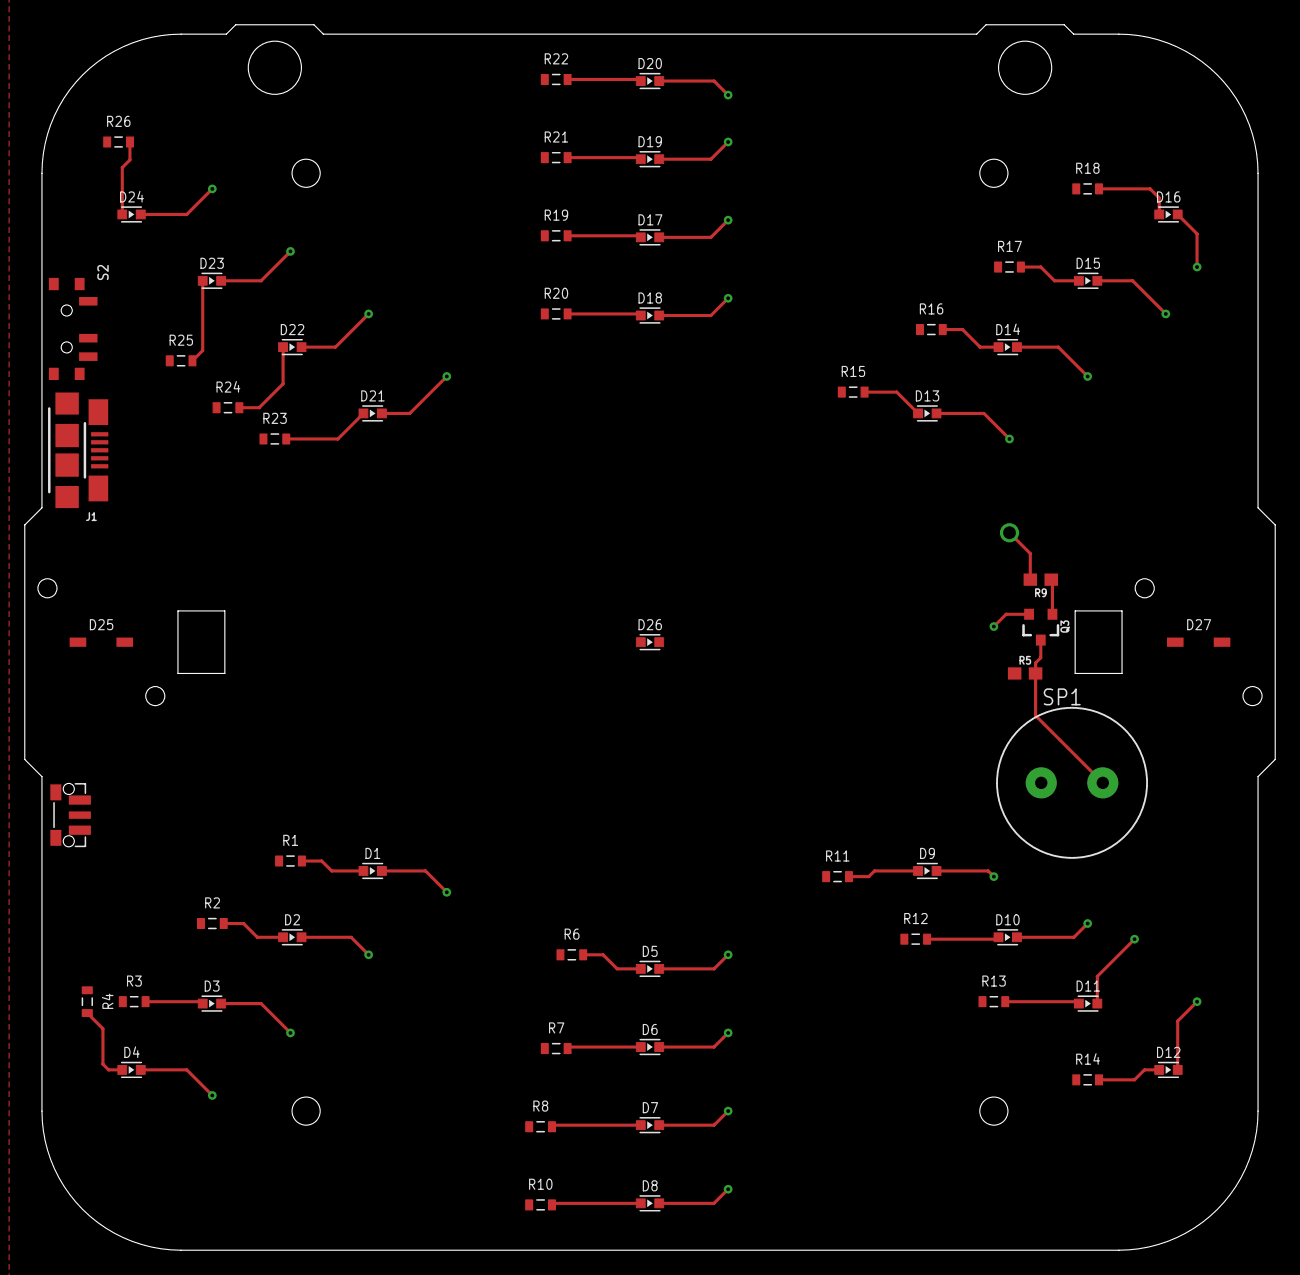
[picture p10: board quick_mock.brd from above]

Board: 2 copper layers, 101.6 x 99.6 mm, 58 parts (0 on the bottom side), 28 nets.
