ristich/TC0xC/Firmware/rev1/sound.cpp

#include "sound.h"

// Contra base theme
void base(uint8_t buzzerPin){
  
  tone(buzzerPin, 466,200  );
  noTone(buzzerPin  );

  tone(buzzerPin, 466,200  );
  noTone(buzzerPin  );

  tone(buzzerPin, 554,200  );
  noTone(buzzerPin  );

  tone(buzzerPin, 466,200  );
  noTone(buzzerPin  );

  tone(buzzerPin, 659,300  );
  noTone(buzzerPin  );

  tone(buzzerPin, 622,300  );
  noTone(buzzerPin  );

  tone(buzzerPin, 554,200  );
  noTone(buzzerPin  );

  tone(buzzerPin, 466,200  );
  noTone(buzzerPin  );

  tone(buzzerPin, 466,200  );
  noTone(buzzerPin  );

  tone(buzzerPin, 554,200  );
  noTone(buzzerPin  );

  tone(buzzerPin, 466,200  );
  noTone(buzzerPin  );

  tone(buzzerPin, 659,300  );
  noTone(buzzerPin  );

  tone(buzzerPin, 622,300  );
  noTone(buzzerPin  );

  tone(buzzerPin, 554,200  );
  noTone(buzzerPin  );

  tone(buzzerPin, 466,200  );
  noTone(buzzerPin  );

  tone(buzzerPin, 466,200  );
  noTone(buzzerPin  );

  tone(buzzerPin, 554,200  );
  noTone(buzzerPin  );

  tone(buzzerPin, 466,200  );
  noTone(buzzerPin  );

  tone(buzzerPin, 659,300  );
  noTone(buzzerPin  );

  tone(buzzerPin, 622,300  );
  noTone(buzzerPin  );

  tone(buzzerPin, 554,200  );
  noTone(buzzerPin  );

  tone(buzzerPin, 466,200  );
  noTone(buzzerPin  );

  tone(buzzerPin, 466,200  );
  noTone(buzzerPin  );

  tone(buzzerPin, 554,200  );
  noTone(buzzerPin  );

  tone(buzzerPin, 466,200  );
  noTone(buzzerPin  );

  tone(buzzerPin, 622,300  );
  noTone(buzzerPin  );

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
  noTone(buzzerPin);

  tone(buzzerPin, 1109,112);
  noTone(buzzerPin);

  tone(buzzerPin, 740,112);
  noTone(buzzerPin);

  tone(buzzerPin, 1109,114);
  noTone(buzzerPin);

  tone(buzzerPin, 740,114);
  noTone(buzzerPin);

  tone(buzzerPin, 1109,125);
  noTone(buzzerPin);

  tone(buzzerPin, 740,125);
  noTone(buzzerPin);
}
