ristich/TC0xC/Firmware/rev1/audio.h

#pragma once

typedef enum Audio_Error
{
    AUDIO_SUCCESS = 0,
} Audio_Error;

// audio object to be passed around for audio control
typedef struct Audio_Object
{
    bool initialized;         // state of audio task creation
    TaskHandle_t task_handle; // task handle
} Audio_Object;

typedef enum Song_Error
{
    SONG_COMPLETE = 0,
    SONG_INTERRUPTED,
    SONG_INDEX_TOO_HIGH,
} Song_Error;

typedef enum Song_Index
{
    NO_SONG = 0,
    DOWN_BTN_SONG,
    LEFT_BTN_SONG,
    UP_BTN_SONG,
    RIGHT_BTN_SONG,
    SELECT_BTN_SONG,
    STAGE_COMPLETE_SONG,
    HIT_SONG,
    RICK_SONG,
    WELCOME_CHIME,
    PE_SONG,
    TOTAL_SONGS, // should always be last
} Song_Index;

typedef struct tone_t
{
    uint16_t note;
    uint16_t hold;
} tone_t;

typedef struct song_t
{
    const tone_t *notes;
    uint32_t length;
} song_t;

Audio_Error audio_init(Audio_Object *audio);
