ristich/TC0xC/(commit log)

2023-01-05 add initial designs for PCB and housing
    [TC0xC_cover_inner.step, TC0xC_cover_outer.step, quick_mock.brd, quick_mock.sch]
2023-01-10 modify inner design for easier injection molding. prepare files for submitting for quotes.
    [TC0xC_cover_inner.step, TC0xC_cover_inner.stl, TC0xC_cover_outer.step, TC0xC_cover_outer.stl]
2023-02-28 add lenses to housing. update PCB dimensions and cutouts to match.
    [TC0xC_cover_inner.step, TC0xC_cover_inner.stl, TC0xC_cover_outer.step, TC0xC_cover_outer.stl, quick_mock.brd]
2023-03-03 ripped up prototype
    [quick_mock.brd, quick_mock.sch, tc0xC_proto.brd, tc0xC_proto.sch, thot_C_proto_bom.xlsx]
2023-03-04 cleaned ripped up prototype
    [tc0xC_proto.brd, tc0xC_proto.sch]
2023-03-06 matrixed LEDs
    [tc0xC_proto.brd, tc0xC_proto.sch]
2023-03-07 adjust hole sizes. replace emitter LEDs
    [quick_mock.brd, quick_mock.sch]
2023-03-08 add keep outs
    [quick_mock.brd]
2023-03-08 remove a few remnant markers
    [quick_mock.brd]
2023-03-08 merged tKeepOut and drills
    [tc0xC_proto.brd]
2023-03-10 right angle momentary placement
    [tc0xC_proto.brd, tc0xC_proto.sch]
2023-03-11 double push rip up
    [tc0xC_proto.brd, tc0xC_proto.sch]
2023-03-11 mirror of batt and switch fix complete
    [tc0xC_proto.brd]
2023-03-11 move switches. add two types of lanyard mounting
    [quick_mock.brd, quick_mock.sch]
2023-03-13 adjust lanyard holes. prep mock PCB for fab.
    [TC0xC_cover_inner.step, TC0xC_cover_outer.step, quick_mock.brd, quick_mock.sch]
2023-03-14 routed with polys
    [tc0xC_proto.brd, tc0xC_proto.sch]
2023-03-16 adjust LED placement. adjust hole and dimension placement.
    [quick_mock.brd, tc0xC_proto.brd]
2023-03-19 adjust dimensions for better fitting for plastics
    [TC0xC_cover_inner.step, TC0xC_cover_inner.stl, TC0xC_cover_outer.step, TC0xC_cover_outer.stl, tc0xC_proto.brd]
2023-03-27 added Release directories
    [BOM293263-240323.xlsx, BOM293263.xlsx, BOM_UE.xlsx, tc0xC_prod.brd, tc0xC_prod.sch]
2023-03-29 updates for new housing design
    [quick_mock.brd, tc0xC_prod.brd]
2023-04-01 add silk. update layout to fit plastics. minor adjustments to layout.
    [tc0xC_prod.brd, tc0xC_prod.sch]
2023-04-04 update cutouts and keepout. minor routing adjustments.
    [tc0xC_prod.brd]
2023-04-05 small layout adjustments
    [tc0xC_prod.brd]
2023-04-05 updated dimension around lanyard holes
    [tc0xC_prod.brd]
2023-04-06 Review CAMS, Art, Schematic Updates - Pre final route
    [tc0xC_prod.brd, tc0xC_prod.sch]
2023-04-08 Hardware and Art dirs
    [BOM_FINAL.xlsx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]
2023-04-10 add 3D models for parts
    [tc0xC_prod.brd, tc0xC_prod.sch]
2023-04-29 move led control to its own files.
2023-04-29 move led object declaration to TC0xC_RTOS.ino.
2023-04-29 add commands for controlling leds from cli.
2023-04-30 bring in led driver autoplay and use that for repetitive led control. add a sempaphore for led update signalling.
2023-05-01 add routine to interrupt led pattern to show new pattern.
2023-05-02 switch to using hardware timer for message alarm.
2023-05-03 add basic letter to led translation.
2023-05-04 add string to led display conversion.
2023-05-06 trigger LEDs with button press.
2023-05-06 change button press to use xnotify.
2023-05-07 add button class for aggregating button info.
2023-05-07 use notify value to set audio and led playback. asign notes to buttons.
2023-05-08 move touch operations to its own task. fix ledc initialization error.
    [TC0xC_RTOS.ino, audio.cpp, hal.h, touch.cpp, touch.h]
2023-05-09 change audio so that a new song will interrupt a currently playing song. add contra stage complete and rick roll songs.
2023-05-10 fix audio playback issues.
    [audio.cpp, audio.h, hal.h, songs.h, touch.cpp, touch.h]
2023-05-10 change cli led updates to happen wi th xnotify instead of binary semaphore.
2023-05-10 stabilized touch for now
    [gold.ino, irc.ino, songs.h, touch.cpp, touch.h]
2023-05-12 add boot led sequence.
2023-05-12 ir task stable plus current build
2023-05-13 add cli led pattern command. add more led patterns.
2023-05-13 adjust help command to print total number of led modes.
